WardBenjamin/RP2040_BLE_Feather/3dmodels/HRO TYPE-C-31-M-12.step

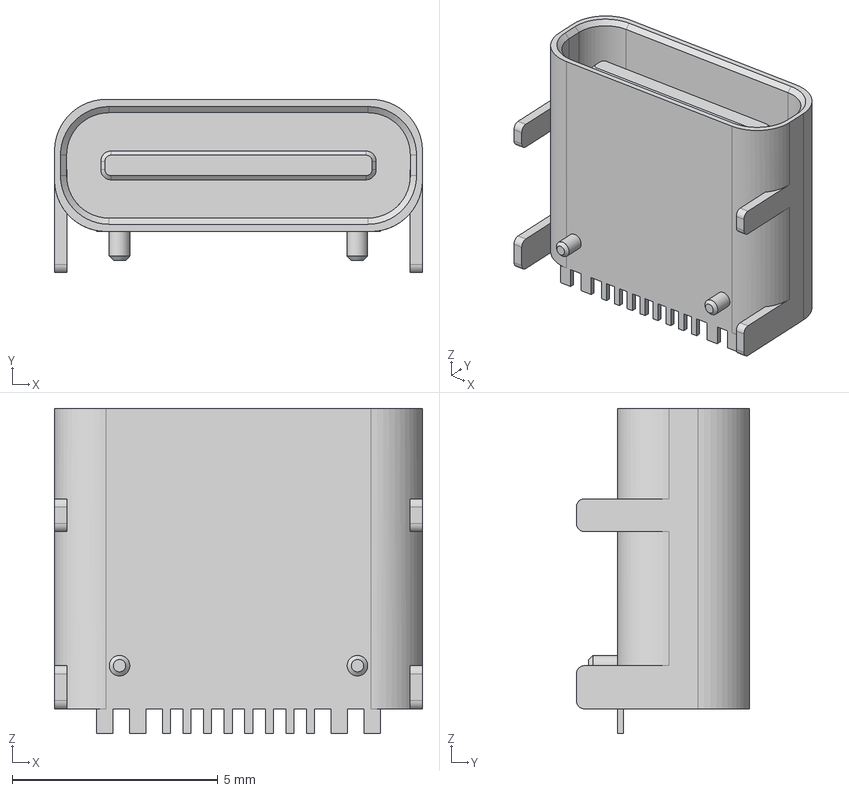
[picture p1: CAD file, 2021-11-11]
3dmodels/HRO TYPE-C-31-M-12.step
8.94 x 4.21 x 7.90 mm
