WardBenjamin/RP2040_BLE_Feather/3dmodels/PTS830GM140GSMTRLFS.stp

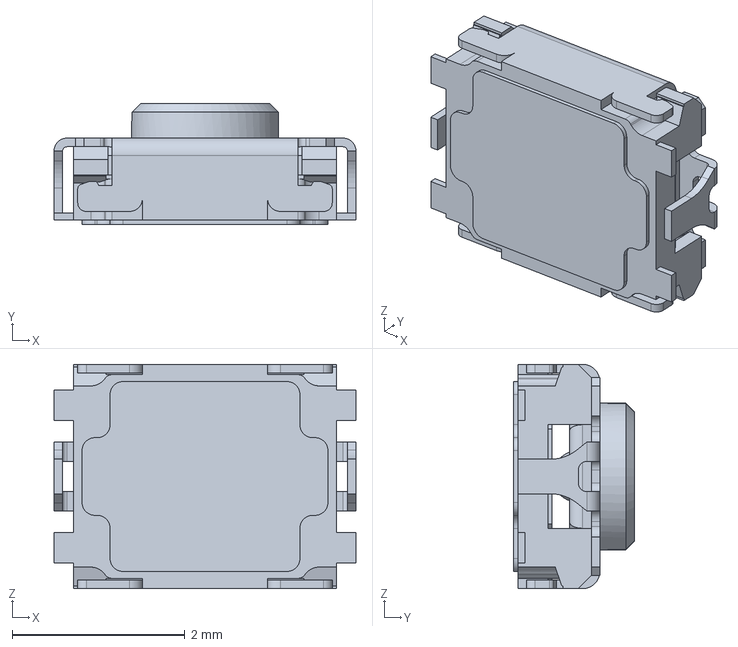
[picture p2: CAD file, 2021-11-11]
3dmodels/PTS830GM140GSMTRLFS.stp
3.50 x 1.40 x 2.60 mm
