WardBenjamin/RP2040_BLE_Feather/rp2040_bt_feather.kicad_pcb

## KiCad design rp2040_bt_feather.kicad_pcb (2021-11-11)

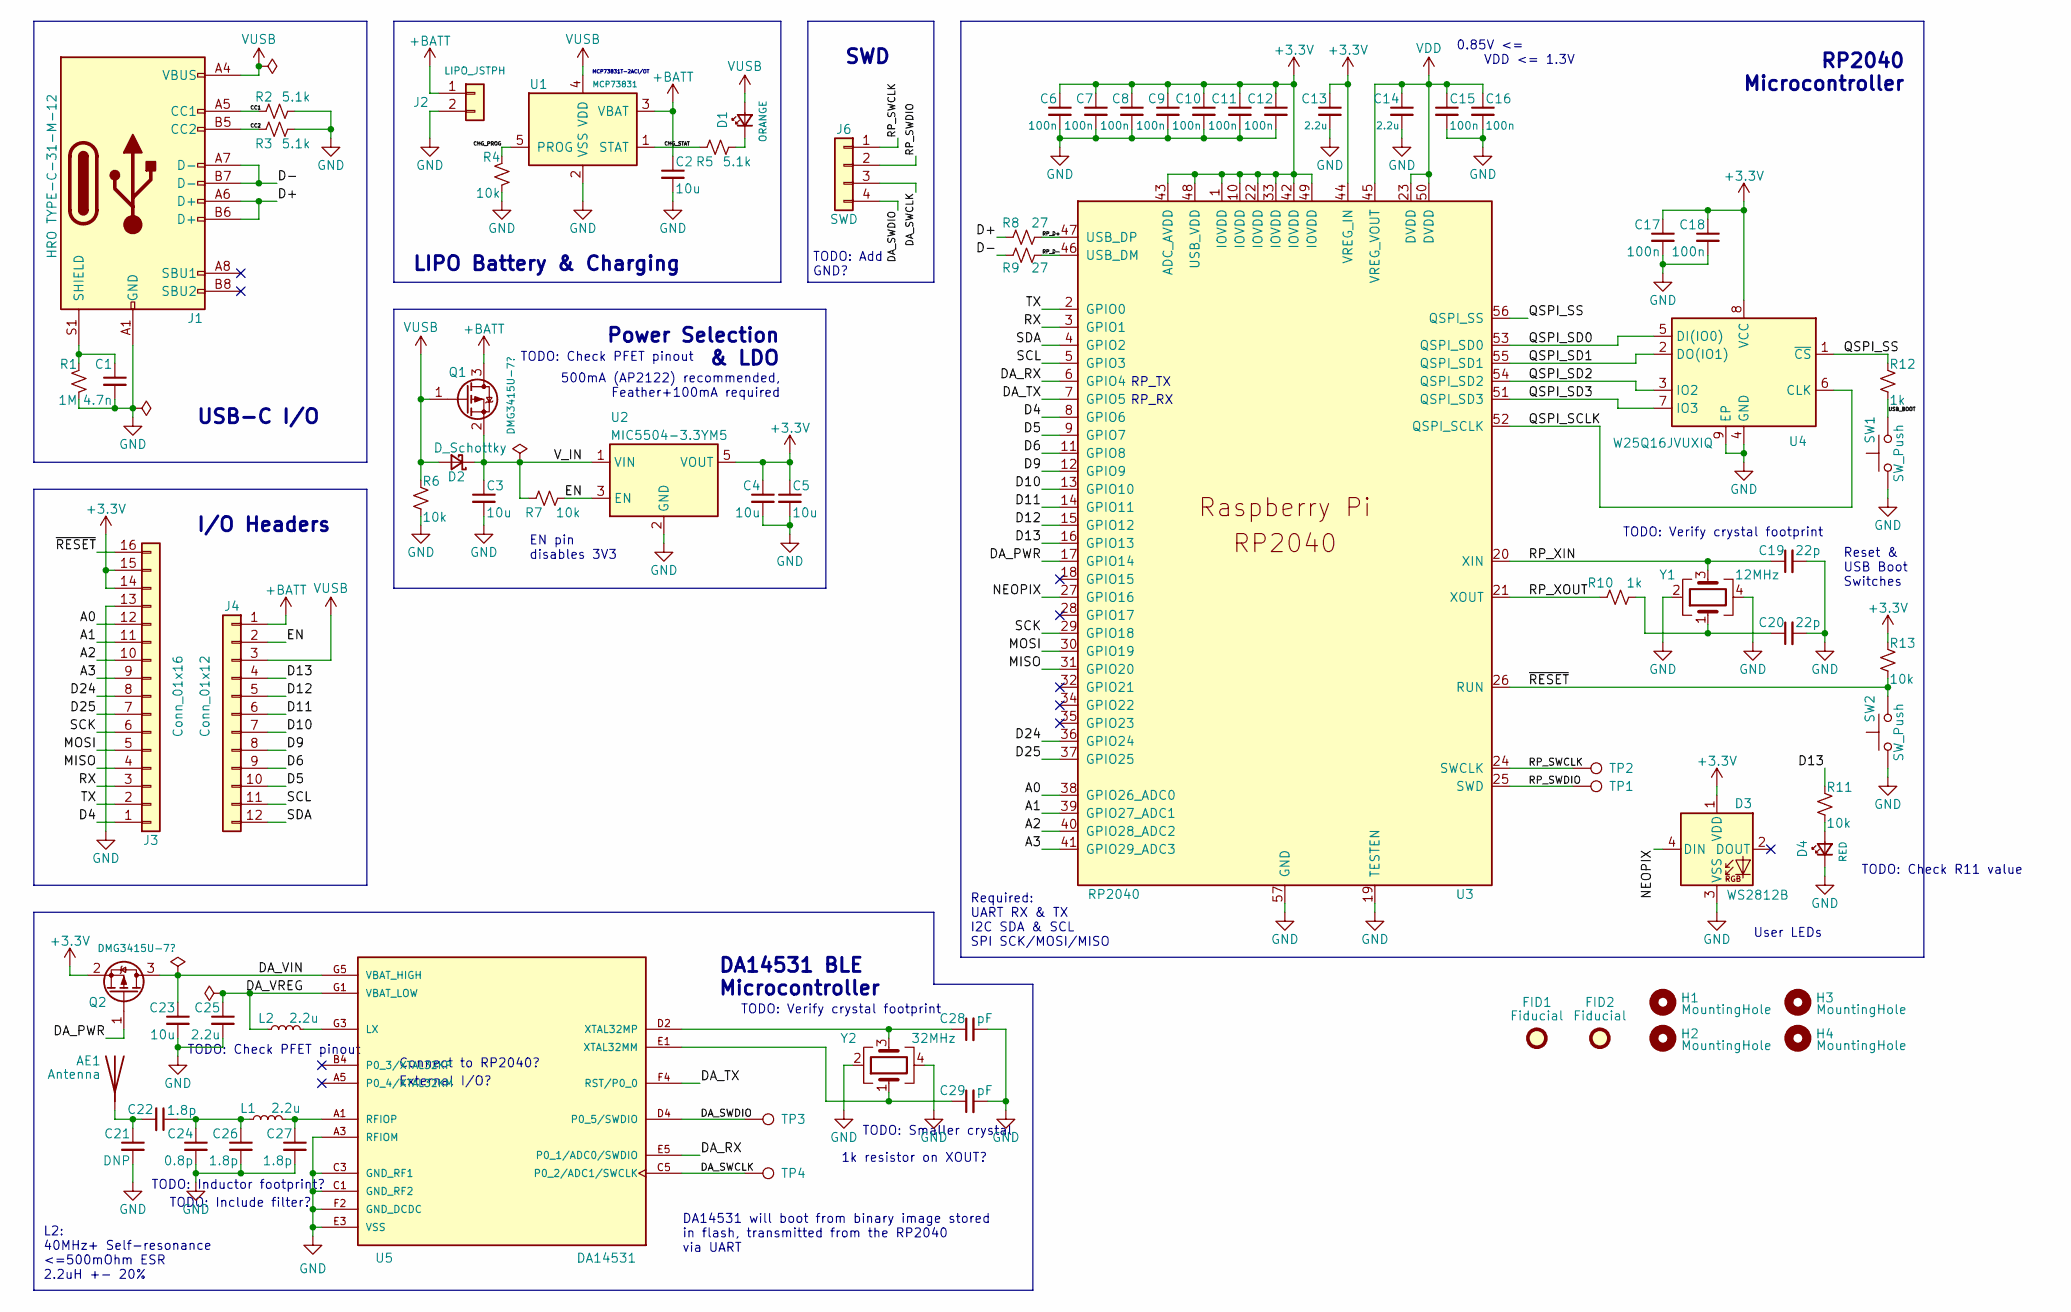
[picture p3: schematic rp2040_bt_feather.kicad_sch, RP2040 BLE Feather]

Parts:
AE1: Antenna
C1: 4.7n; C_0603_1608Metric
C2, C3, C4, C5: 10u; C_0805_2012Metric
C6, C7, C8, C9, C10, C11, C12, C15, C16, C17, C18: 100n; C_0603_1608Metric
C13, C14, C25: 2.2u; C_0603_1608Metric
C19, C20: 22p; C_0603_1608Metric
C21: DNP; C_0603_1608Metric
C22, C26, C27: 1.8p; C_0603_1608Metric
C23: 10u; C_0603_1608Metric
C24: 0.8p; C_0603_1608Metric
C28, C29: pF; C_0603_1608Metric
D1: ORANGE; D_0603_1608Metric; MPN ‎LTST-C190KFKT
D2: D_Schottky; D_SOD-123F
D3: WS2812B; LED_WS2812B_PLCC4_5.0x5.0mm_P3.2mm
D4: RED; D_0603_1608Metric
FID1, FID2: Fiducial; Fiducial_1mm_Mask2mm
H1, H2, H3, H4: MountingHole; MountingHole_2.5mm
J1: HRO TYPE-C-31-M-12; USB_C_Receptacle_HRO_TYPE-C-31-M-12
J2: LIPO_JSTPH; JST_PH_S2B-PH-SM4-TB_1x02-1MP_P2.00mm_Horizontal
J3: Conn_01x16; PinHeader_1x16_P2.54mm_Vertical
J4: Conn_01x12; PinHeader_1x12_P2.54mm_Vertical
J6: SWD; PinHeader_1x04_P2.54mm_Vertical
L1: 2.2u; L_0603_1608Metric
L2: 2.2u; L_0805_2012Metric
Q1, Q2: DMG3415U-7?; SOT-23
R1: 1M; R_0603_1608Metric
R2, R3, R5: 5.1k; R_0603_1608Metric
R4, R6, R7, R11, R13: 10k; R_0603_1608Metric
R8, R9: 27; R_0603_1608Metric
R10, R12: 1k; R_0603_1608Metric
SW1, SW2: SW_Push; SW_SPST_PTS830
TP1, TP3: SWDIO; TestPoint_THTPad_1.0x1.0mm_Drill0.5mm
TP2, TP4: SWCLK; TestPoint_THTPad_1.0x1.0mm_Drill0.5mm
U1: MCP73831; SOT-23-5; MPN MCP73831T-2ACI/OT
U2: MIC5504-3.3YM5; SOT-23-5
U3: RP2040; RP2040-QFN-56
U4: W25Q16JVUXIQ; WSON-8-1EP_6x5mm_P1.27mm_EP3.4x4.3mm
U5: DA14531; XCVR_DA14531-00000OG2; PARTREV 2.1
Y1: 12MHz; Crystal_SMD_2016-4Pin_2.0x1.6mm
Y2: 32MHz; Crystal_SMD_2016-4Pin_2.0x1.6mm; MPN ECS-320-8-37B-CKY-TR

Connections:
+3V3: C4.1, C5.1, C6.1, C7.1, C8.1, C9.1, C10.1, C11.1, C12.1, C13.1, C17.1, C18.1, D3.1 (VDD), J3.14, J3.15, Q2.2 (S), R13.1, U2.5 (VOUT), U3.1 (IOVDD), U3.10 (IOVDD), U3.22 (IOVDD), U3.33 (IOVDD), U3.42 (IOVDD), U3.43 (ADC_AVDD), U3.44 (VREG_IN), U3.48 (USB_VDD), U3.49 (IOVDD), U4.8 (VCC)
+BATT: C2.1, J2.1, J4.1, Q1.3 (D), U1.3 (VBAT)
/A0: J3.12, U3.38 (GPIO26_ADC0)
/A1: J3.11, U3.39 (GPIO27_ADC1)
/A2: J3.10, U3.40 (GPIO28_ADC2)
/A3: J3.9, U3.41 (GPIO29_ADC3)
/CC1: J1.A5 (CC1), R2.1
/CC2: J1.B5 (CC2), R3.1
/CHG_PROG: R4.1, U1.5 (PROG)
/CHG_STAT: R5.1, U1.1 (STAT)
/D4: J3.1, U3.8 (GPIO6)
/D5: J4.10, U3.9 (GPIO7)
/D6: J4.9, U3.11 (GPIO8)
/D9: J4.8, U3.12 (GPIO9)
/D10: J4.7, U3.13 (GPIO10)
/D11: J4.6, U3.14 (GPIO11)
/D12: J4.5, U3.15 (GPIO12)
/D13: J4.4, R11.1, U3.16 (GPIO13)
/D24: J3.8, U3.36 (GPIO24)
/D25: J3.7, U3.37 (GPIO25)
/D+: J1.A6 (D+), J1.B6 (D+), R8.1; also elsewhere on the board
/D-: J1.A7 (D-), J1.B7 (D-), R9.1; also elsewhere on the board
/DA_PWR: Q2.1 (G), U3.17 (GPIO14)
/DA_RX: U3.6 (GPIO4), U5.E5 (P0_1/ADC0/SWDIO)
/DA_SWCLK: J6.3, TP4.1, U5.C5 (P0_2/ADC1/SWCLK)
/DA_SWDIO: J6.4, TP3.1, U5.D4 (P0_5/SWDIO); also elsewhere on the board
/DA_TX: U3.7 (GPIO5), U5.F4 (RST/P0_0)
/DA_VIN: C23.1, Q2.3 (D), U5.G5 (VBAT_HIGH)
/DA_VREG: C25.1, L2.1, U5.G1 (VBAT_LOW)
/EN: J4.2, R7.2, U2.3 (EN)
/MISO: J3.4, U3.31 (GPIO20)
/MOSI: J3.5, U3.30 (GPIO19)
/NEOPIX: D3.4 (DIN), U3.27 (GPIO16)
/QSPI_SCLK: U3.52 (QSPI_SCLK), U4.6 (CLK)
/QSPI_SD0: U3.53 (QSPI_SD0), U4.5 (DI(IO0))
/QSPI_SD1: U3.55 (QSPI_SD1), U4.2 (DO(IO1))
/QSPI_SD2: U3.54 (QSPI_SD2), U4.3 (IO2)
/QSPI_SD3: U3.51 (QSPI_SD3), U4.7 (IO3)
/QSPI_SS: R12.1, U3.56 (QSPI_SS), U4.1 (~CS)
/RP_D+: R8.2, U3.47 (USB_DP)
/RP_D-: R9.2, U3.46 (USB_DM)
/RP_SWCLK: J6.1, TP2.1, U3.24 (SWCLK); also elsewhere on the board
/RP_SWDIO: J6.2, TP1.1, U3.25 (SWD); also elsewhere on the board
/RP_XIN: C19.1, U3.20 (XIN), Y1.3
/RP_XOUT: R10.1, U3.21 (XOUT)
/RX: J3.3, U3.3 (GPIO1)
/SCK: J3.6, U3.29 (GPIO18)
/SCL: J4.11, U3.5 (GPIO3)
/SDA: J4.12, U3.4 (GPIO2)
/TX: J3.2, U3.2 (GPIO0)
/USB_BOOT: R12.2, SW1.2
/V_IN: C3.1, D2.1 (K), Q1.2 (S), R7.1, U2.1 (VIN)
/~RESET: J3.16, R13.2, SW2.2, U3.26 (RUN)
GND: C1.2, C2.2, C3.2, C4.2, C5.2, C6.2, C7.2, C8.2, C9.2, C10.2, C11.2, C12.2, C13.2, C14.2, C15.2, C16.2, C17.2, C18.2, C19.2, C20.2, C21.2, C23.2, C24.2, C25.2, C26.2, C27.2, C28.2, C29.2, D3.3 (VSS), D4.1 (K), J1.A1 (GND), J1.A12 (GND), J1.B1 (GND), J1.B12 (GND), J2.2, J3.13, R1.2, R2.2, R3.2, R4.2, R6.2, SW1.1, SW2.1, U1.2 (VSS), U2.2 (GND), U3.19 (TESTEN), U3.57 (GND), U4.4 (GND), U4.9 (EP), U5.A3 (RFIOM), U5.C1 (GND_RF2), U5.C3 (GND_RF1), U5.E3 (VSS), U5.F2 (GND_DCDC), Y1.2, Y1.4, Y2.2, Y2.4
unnamed: AE1.1, C21.1, C22.2
unnamed: C1.1, J1.S1 (SHIELD), R1.1
unnamed: C20.1, R10.2, Y1.1
unnamed: C22.1, C24.1, C26.1, L1.1
unnamed: C27.1, L1.2, U5.A1 (RFIOP)
unnamed: C28.1, U5.D2 (XTAL32MP), Y2.3
unnamed: C29.1, U5.E1 (XTAL32MM), Y2.1
unnamed: D1.1 (K), R5.2
unnamed: D4.2 (A), R11.2
unnamed: L2.2, U5.G3 (LX)
VDD: C14.1, C15.1, C16.1, U3.23 (DVDD), U3.45 (VREG_VOUT), U3.50 (DVDD)
VUSB: D1.2 (A), D2.2 (A), J1.A4 (VBUS), J1.A9 (VBUS), J1.B4 (VBUS), J1.B9 (VBUS), J4.3, Q1.1 (G), R6.1, U1.4 (VDD)

Notes on the sheet:
L2: 40MHz+ Self-resonance <=500mOhm ESR 2.2uH +- 20%
TODO: Inductor footprint?
TODO: Include filter?
TODO: Check PFET pinout
USB-C I/O
I/O Headers
Connect to RP2040?
External I/O?
LIPO Battery & Charging
EN pin disables 3V3
MCP73831T-2ACI/OT
DA14531 will boot from binary image stored in flash, transmitted from the RP2040 via UART
DA14531 BLE Microcontroller
TODO: Verify crystal footprint
Power Selection & LDO
500mA (AP2122) recommended, Feather+100mA required
TODO: Add GND?
SWD
TODO: Smaller crystal
Required: UART RX & TX I2C SDA & SCL SPI SCK/MOSI/MISO
1k resistor on XOUT?
RP_TX
RP_RX
0.85V <= VDD <= 1.3V
User LEDs
Reset & USB Boot Switches
TODO: Check R11 value
RP2040 Microcontroller

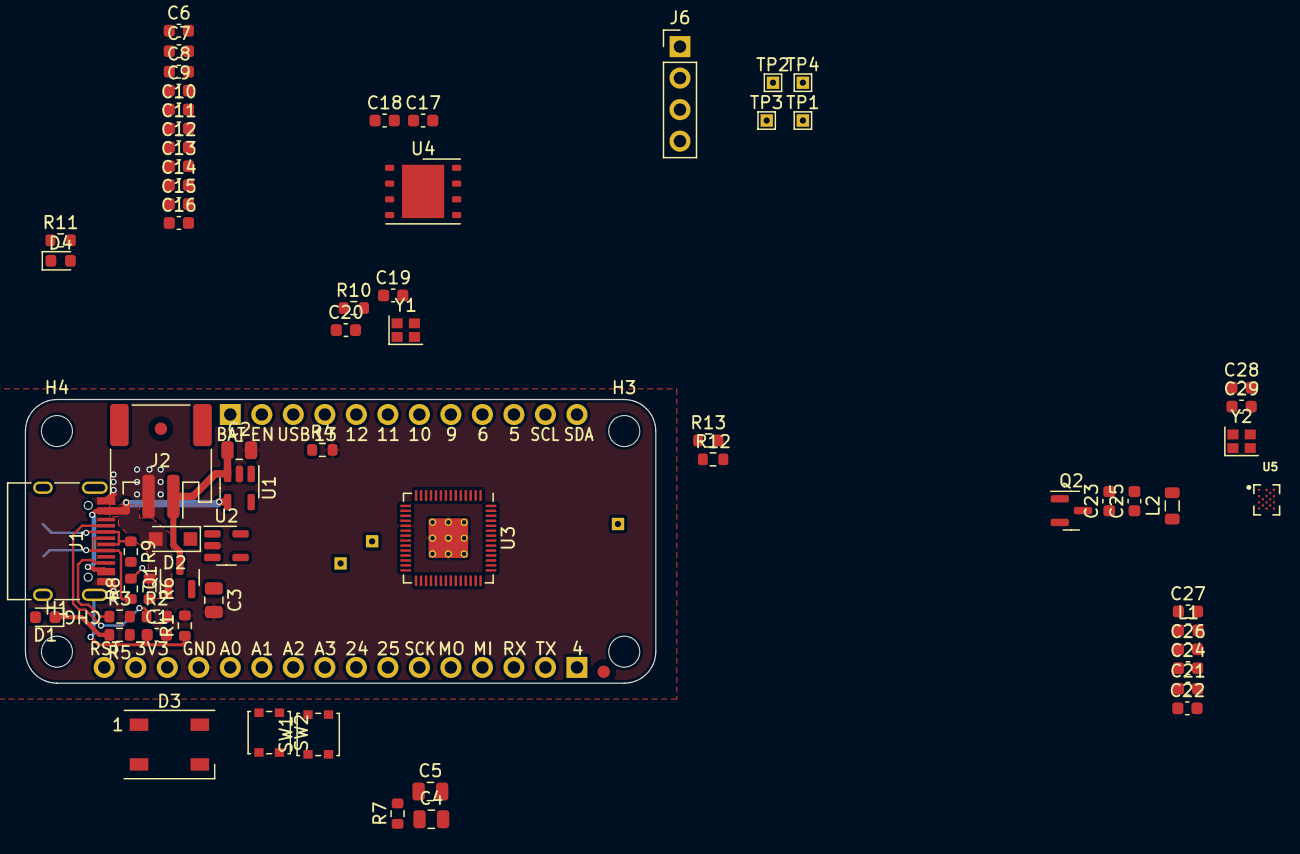
[picture p4: board rp2040_bt_feather.kicad_pcb from above]

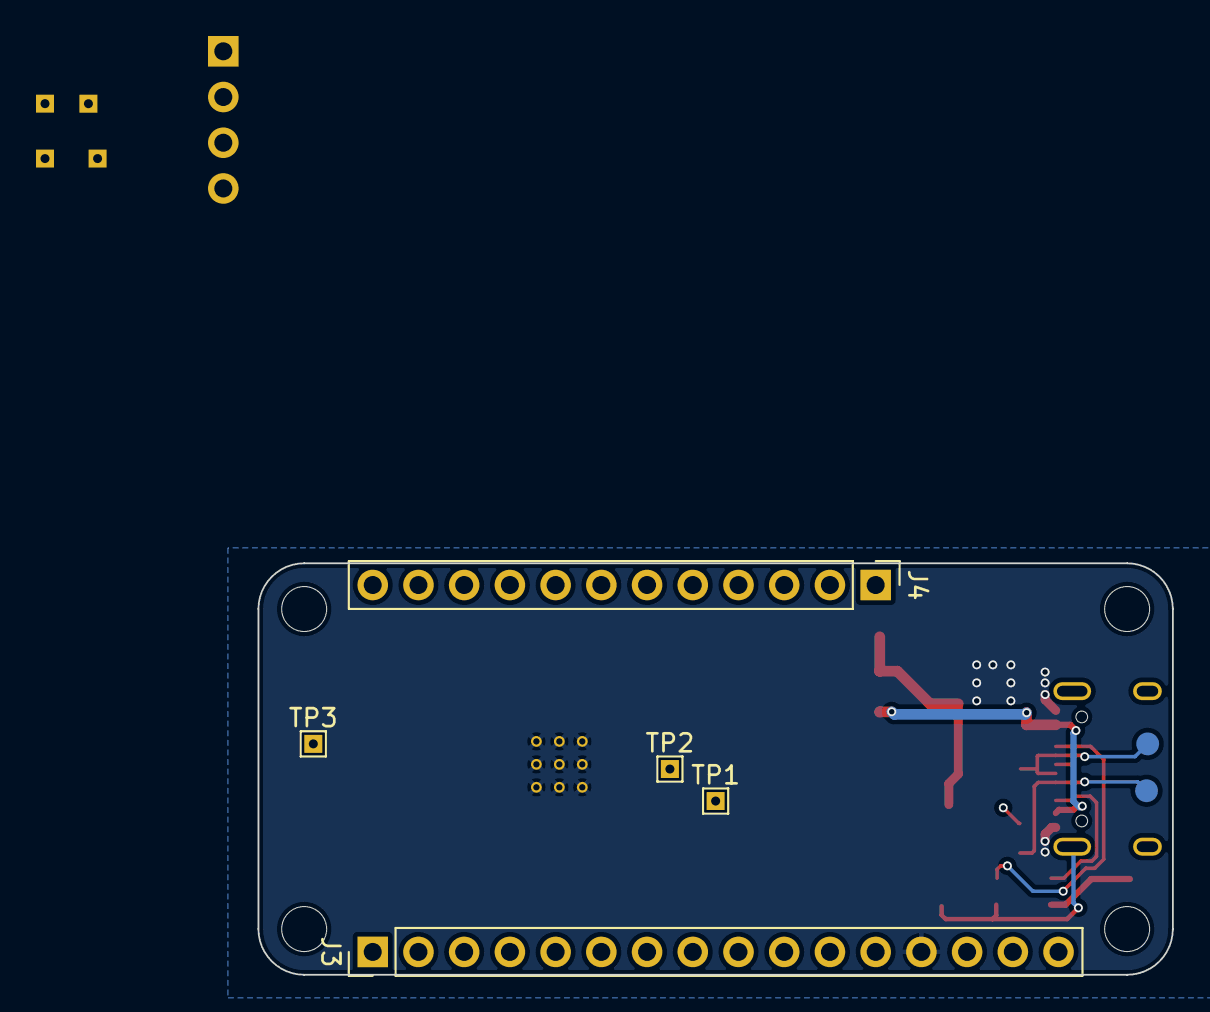
[picture p5: board rp2040_bt_feather.kicad_pcb from below]

Board: 2 copper layers, 50.8 x 22.9 mm, 79 parts (7 on the bottom side), 66 nets.

Other parts of the board:
D+1: TPB1,27; B1,27
D-1: TPB1,27; B1,27
TP1#2, TP3#2: SWDIO; TestPoint_THTPad_1.0x1.0mm_Drill0.5mm
TP2#2: SWCLK; TestPoint_THTPad_1.0x1.0mm_Drill0.5mm

Their connections:
/D+: D+1.TP; also elsewhere on the board
/D-: D-1.TP; also elsewhere on the board
/DA_SWDIO: TP3#2.1; also elsewhere on the board
/RP_SWCLK: TP2#2.1; also elsewhere on the board
/RP_SWDIO: TP1#2.1; also elsewhere on the board
